MissouriMRDT/Smart_MoCo/README.md

# Smart_MoCo_Hardware

Motor controller breakout with VNH ICs, a microcontroller, and CANbus. 
Transmits encoder, limit switch, and motor controller data over CAN.
