MissouriMRDT/Smart_MoCo/Hardware/board/Smart_MoCo.step

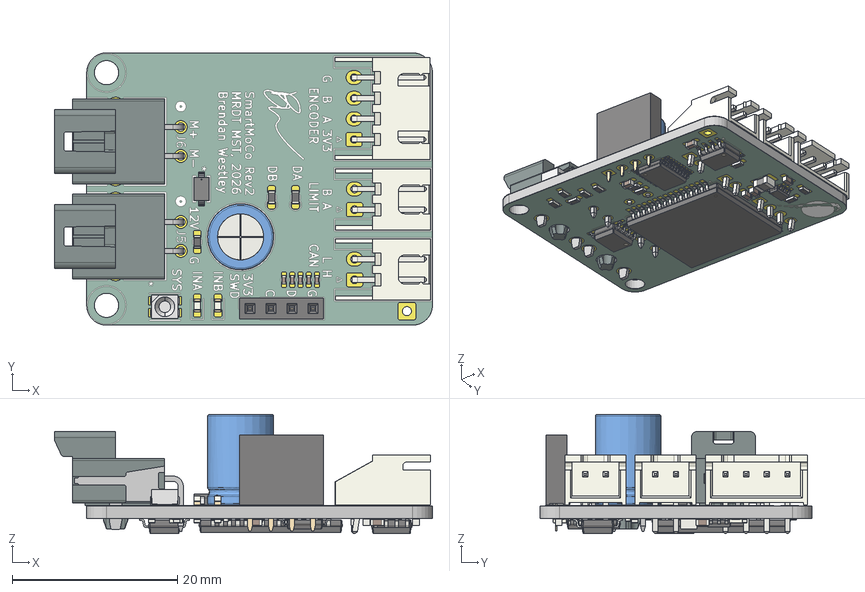
[picture p1: CAD file, 2026-03-16]
Hardware/board/Smart_MoCo.step
45.8 x 33.0 x 14.4 mm
C_0402_1005Metric x 5
R_0603_1608Metric x 13
XZxxxx45
LED_0603_1608Metric x 2
JST_XH_S4B-XH-A_1x04_P2.50mm_Horizontal
C_Radial_D8.0mm_H11.5mm_P3.50mm
JST_XH_S2B-XH-A_1x02_P2.50mm_Horizontal x 2
kicad_embedded_97F6719110B04A8EB39838BF1081E5DA
PinSocket_1x04_P2.54mm_Vertical
SOIC-8_3.9x4.9mm_P1.27mm x 2
TSSOP-20_4.4x6.5mm_P0.65mm
C_0603_1608Metric x 5
L_1008_2520Metric
ST_MultiPowerSO-30
TSOT-23-6
Smart_MoCo_copper
Smart_MoCo_silkscreen x 2
Smart_MoCo_soldermask x 2
Smart_MoCo_PCB
