MissouriMRDT/Smart_MoCo/Hardware/board/simulation/Power Supplies.asc

C1: cap; 1m
I1: current; PWL(0 0 +1m 100m +1m 10m +1m 0 +1u 1u +1u 1u +1u 0 +1m 0 +1n 1 +1n 0)
V1: voltage; 3.3; Rser=10m
Named nets: 0
.tran 0.01
