MissouriMRDT/Smart_MoCo/Hardware/board/Smart_MoCo.kicad_pcb

## KiCad design Hardware/board/Smart_MoCo.kicad_pcb (2026-03-23)

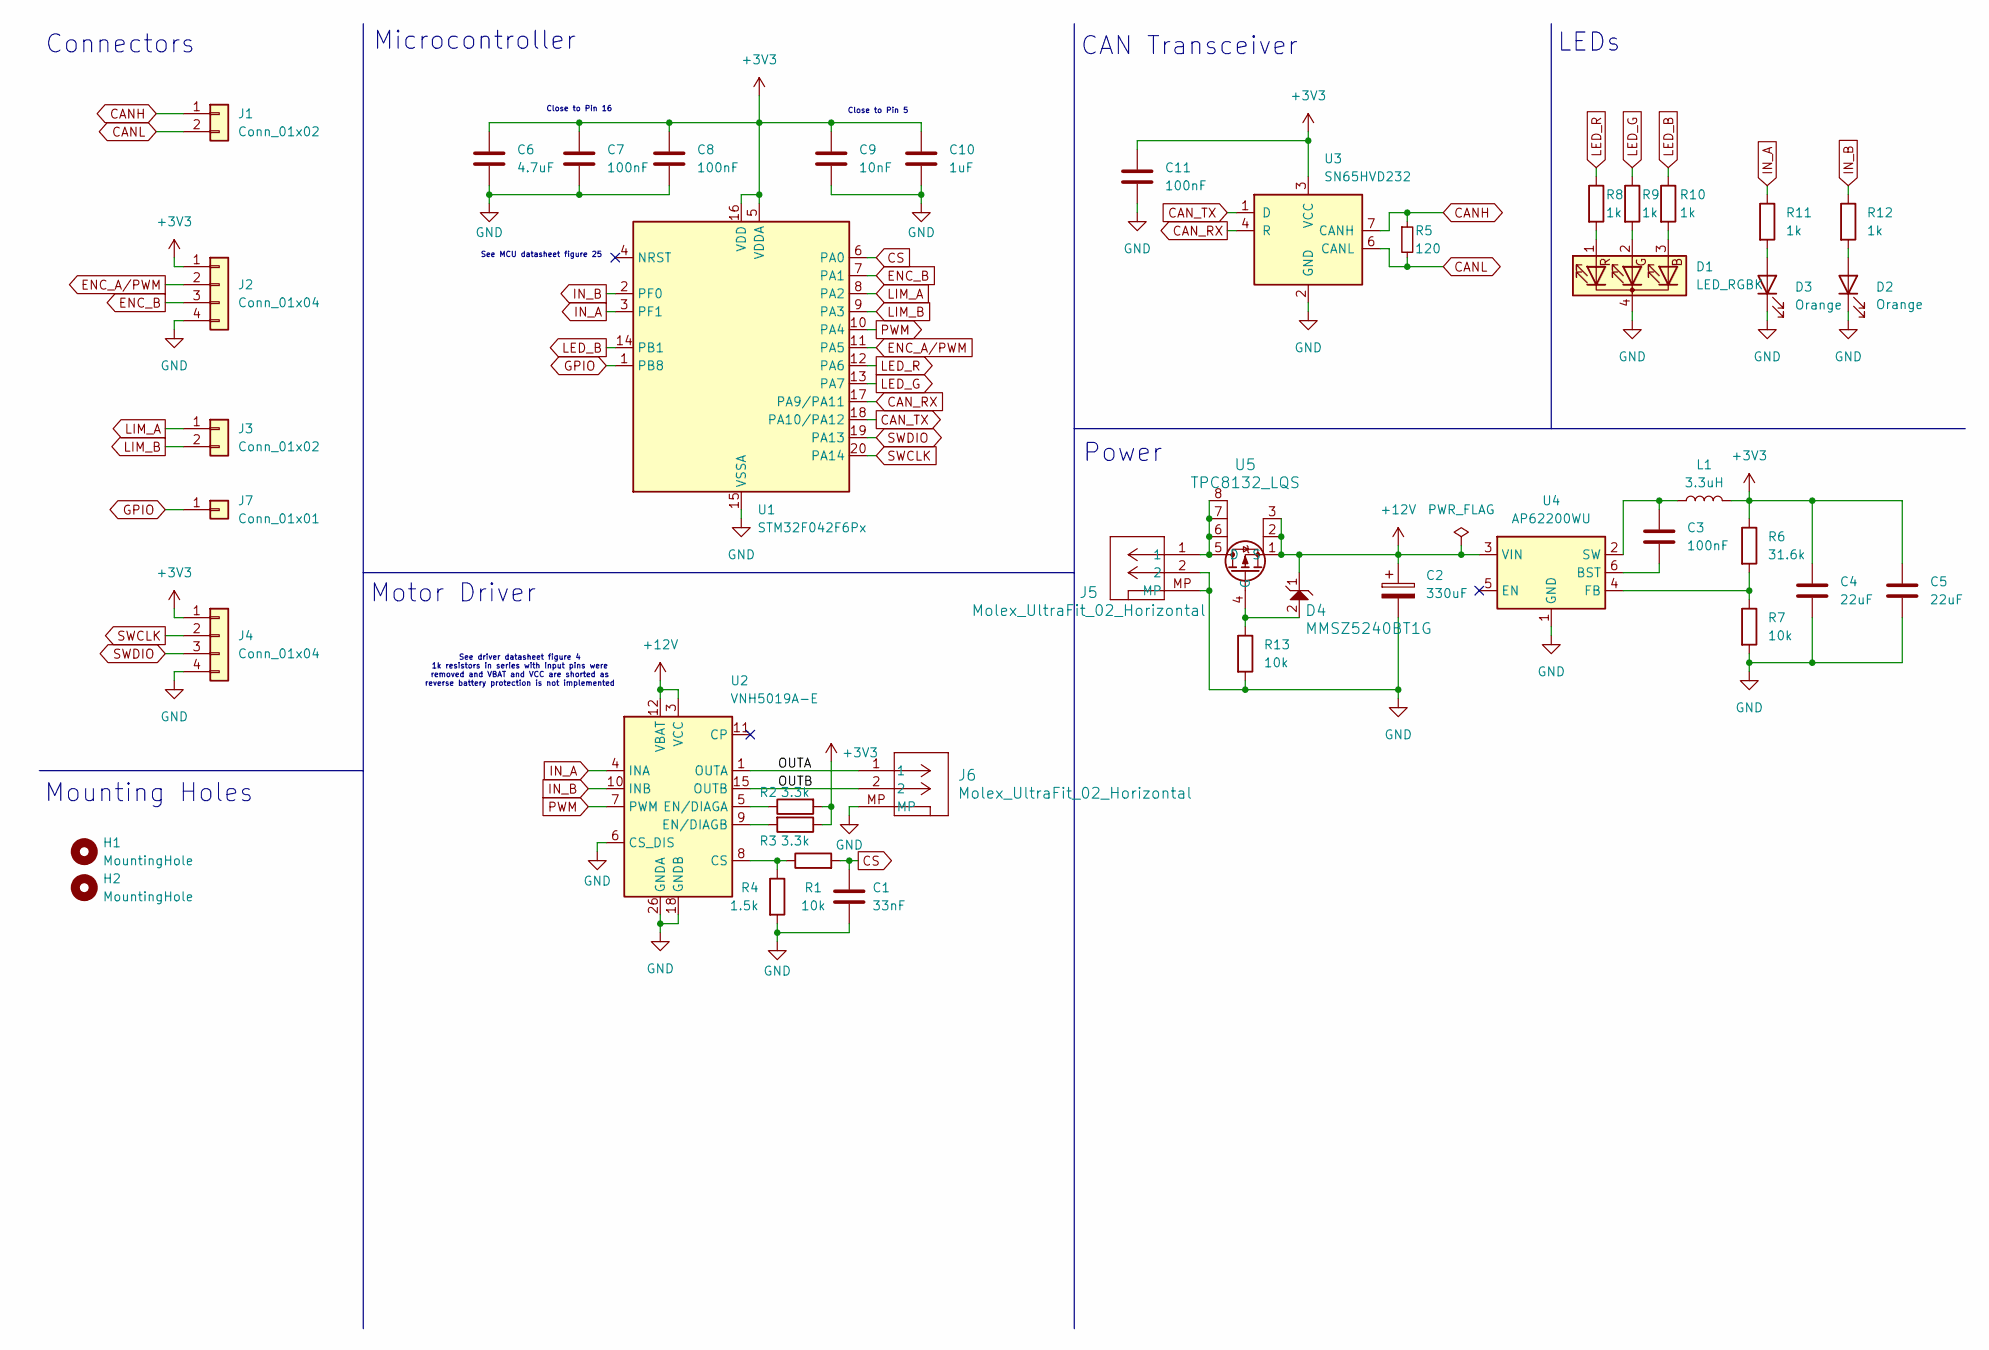
[picture p2: schematic Smart_MoCo.kicad_sch, Smart Brushed Motor Controller]

Parts:
C1: 33nF; C_0603_1608Metric_Pad1.08x0.95mm_HandSolder
C2: 330uF; C_Radial_D8.0mm_H11.5mm_P3.50mm
C3, C11: 100nF; C_0603_1608Metric_Pad1.08x0.95mm_HandSolder
C4, C5: 22uF; C_0603_1608Metric_Pad1.08x0.95mm_HandSolder
C6: 4.7uF; C_0402_1005Metric_Pad0.74x0.62mm_HandSolder
C7, C8: 100nF; C_0402_1005Metric_Pad0.74x0.62mm_HandSolder
C9: 10nF; C_0402_1005Metric_Pad0.74x0.62mm_HandSolder
C10: 1uF; C_0402_1005Metric_Pad0.74x0.62mm_HandSolder
D1: LED_RGBK; PLCC4_3p5x2p8_SLD-L
D2, D3: Orange; LED_0603_1608Metric_Pad1.05x0.95mm_HandSolder
D4: MMSZ5240BT1G; SOD-123_ONS-L
H1, H2: MountingHole; Minimal_4_40_Hole
J1, J3: Conn_01x02; JST_XH_S2B-XH-A_1x02_P2.50mm_Horizontal
J2: Conn_01x04; JST_XH_S4B-XH-A_1x04_P2.50mm_Horizontal
J4: Conn_01x04; PinSocket_1x04_P2.54mm_Vertical
J5, J6: Molex_UltraFit_02_Horizontal; MOLEX_UltraFit_02_Horizontal; MPN 1723102000
J7: Conn_01x01; SolderWire-0.5sqmm_1x01_D0.9mm_OD2.1mm
L1: 3.3uH; L_1008_2520Metric_Pad1.43x2.20mm_HandSolder
R1, R7, R13: 10k; R_0603_1608Metric_Pad0.98x0.95mm_HandSolder
R2, R3: 3.3k; R_0603_1608Metric_Pad0.98x0.95mm_HandSolder
R4: 1.5k; R_0603_1608Metric_Pad0.98x0.95mm_HandSolder
R5: 120; R_0603_1608Metric_Pad0.98x0.95mm_HandSolder
R6: 31.6k; R_0603_1608Metric_Pad0.98x0.95mm_HandSolder
R8, R9, R10, R11, R12: 1k; R_0603_1608Metric_Pad0.98x0.95mm_HandSolder
U1: STM32F042F6Px; TSSOP-20_4.4x6.5mm_P0.65mm
U2: VNH5019A-E; ST_MultiPowerSO-30
U3: SN65HVD232; SOIC-8_3.9x4.9mm_P1.27mm
U4: AP62200WU; TSOT-23-6
U5: TPC8132_LQS; SOIC-8_3.9x4.9mm_P1.27mm

Connections:
+3V3: C4.1, C5.1, C6.1, C7.1, C8.1, C9.1, C10.1, C11.1, J2.1, J4.1, L1.2, R2.2, R3.1, R6.1, U1.5 (VDDA), U1.16 (VDD), U3.3 (VCC)
+12V: C2.1, D4.1, U2.3 (VCC), U2.12 (VBAT), U2.13 (VCC), U2.23 (VCC), U2.31 (VCC), U4.3 (VIN), U5.1 (S), U5.2, U5.3
/OUTA: J6.1, U2.1 (OUTA), U2.25 (OUTA), U2.30 (OUTA), U2.33 (OUTA)
/OUTB: J6.2, U2.15 (OUTB), U2.16 (OUTB), U2.21 (OUTB), U2.32 (OUTB)
CANH: J1.1, R5.1, U3.7 (CANH)
CANL: J1.2, R5.2, U3.6 (CANL)
CAN_RX: U1.17 (PA9/PA11), U3.4 (R)
CAN_TX: U1.18 (PA10/PA12), U3.1 (D)
CS: C1.2, R1.2, U1.6 (PA0)
ENC_A/PWM: J2.2, U1.11 (PA5)
ENC_B: J2.3, U1.7 (PA1)
GND: C1.1, C2.2, C4.2, C5.2, C6.2, C7.2, C8.2, C9.2, C10.2, C11.2, D1.4 (K), D2.1 (K), D3.1 (K), J2.4, J4.4, J5.2, J5.MP, J6.MP, R4.2, R7.2, R13.2, U1.15 (VSSA), U2.6 (CS_DIS), U2.18 (GNDB), U2.19 (GNDB), U2.20 (GNDB), U2.26 (GNDA), U2.27 (GNDA), U2.28 (GNDA), U3.2 (GND), U4.1 (GND)
GPIO: J7.1, U1.1 (PB8)
IN_A: R11.1, U1.3 (PF1), U2.4 (INA)
IN_B: R12.1, U1.2 (PF0), U2.10 (INB)
LED_B: R10.1, U1.14 (PB1)
LED_G: R9.1, U1.13 (PA7)
LED_R: R8.1, U1.12 (PA6)
LIM_A: J3.1, U1.8 (PA2)
LIM_B: J3.2, U1.9 (PA3)
unnamed: D1.3 (BA), R10.2
unnamed: D1.2 (GA), R9.2
unnamed: D1.1 (RA), R8.2
unnamed: D2.2 (A), R12.2
unnamed: D3.2 (A), R11.2
unnamed: R1.1, R4.1, U2.8 (CS)
unnamed: R2.1, U2.5 (EN/DIAGA)
unnamed: R3.2, U2.9 (EN/DIAGB)
unnamed: C3.2, U4.6 (BST)
unnamed: R6.2, R7.1, U4.4 (FB)
unnamed: C3.1, L1.1, U4.2 (SW)
unnamed: J5.1, U5.5 (D), U5.6, U5.7, U5.8
unnamed: D4.2, R13.1, U5.4 (G)
PWM: U1.10 (PA4), U2.7 (PWM)
SWCLK: J4.2, U1.20 (PA14)
SWDIO: J4.3, U1.19 (PA13)

Notes on the sheet:
See MCU datasheet figure 25
Close to Pin 5
See driver datasheet figure 4 1k resistors in series with input pins were removed and VBAT and VCC are shorted as reverse battery protection is not implemented
Close to Pin 16
Power
Connectors
Motor Driver
CAN Transceiver
Microcontroller
LEDs
Mounting Holes

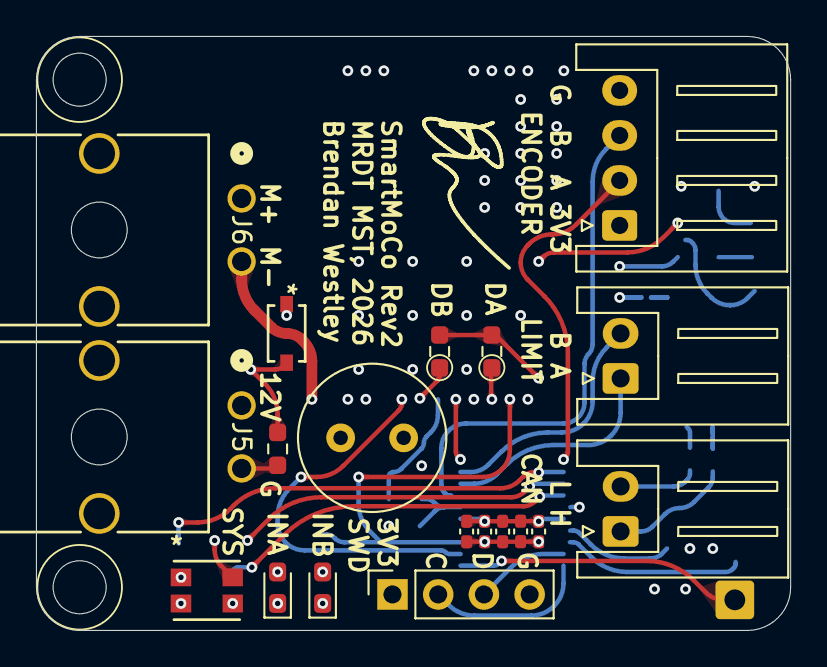
[picture p3: board Smart_MoCo.kicad_pcb from above]

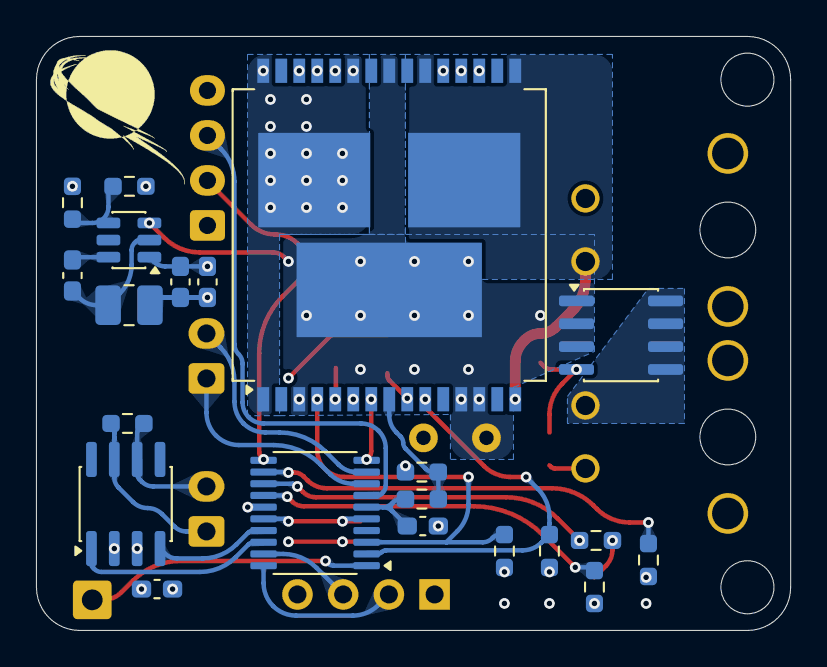
[picture p4: board Smart_MoCo.kicad_pcb from below]

Board: 4 copper layers, 41.9 x 33.0 mm, 43 parts (22 on the bottom side), 36 nets.
