MissouriMRDT/Smart_MoCo/Software/Smart_MoCo/Core/Src/main.c

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
/* Includes ------------------------------------------------------------------*/
#include "main.h"
#include "adc.h"
#include "gpio.h"
#include "tim.h"

/* USER CODE BEGIN Includes */
#include "can.h"
#include "can_rx.h"
#include "encoder.h"
#include <stdbool.h>
#include <stdint.h>

/* USER CODE END Includes */


/* USER CODE BEGIN PV */
volatile uint64_t sysTickOffset = TICKS_PER_MS;
/* USER CODE END PV */

void SystemClock_Config(void);
/**
 * @brief  The application entry point.
 * @retval int
 */
int main(void) {

  /* MCU Configuration--------------------------------------------------------*/

  /* Reset of all peripherals, Initializes the Flash interface and the Systick.
   */
  LL_APB1_GRP2_EnableClock(LL_APB1_GRP2_PERIPH_SYSCFG);
  LL_APB1_GRP1_EnableClock(LL_APB1_GRP1_PERIPH_PWR);

  LL_SYSCFG_EnablePinRemap();

  /* Configure the system clock */
  SystemClock_Config();

  /* Initialize all configured peripherals */
  MX_GPIO_Init();
  MX_ADC_Init();
  MX_TIM2_Init();
  MX_TIM14_Init();
  MX_TIM1_Init();
  MX_TIM17_Init();
  MX_TIM3_Init();
  /* USER CODE BEGIN 2 */
  LL_SYSTICK_EnableIT();
  Controller_Init();
  Encoder_Init();
  CAN_RX_Init();

  LL_TIM_EnableIT_CC1(TIM_SCHEDULER); // Schedule CAN_TX_SendTelemetry
  LL_TIM_EnableIT_CC2(TIM_SCHEDULER); // Schedule CAN_TX_SendDebugTelemetry
  LL_TIM_EnableIT_CC3(TIM_SCHEDULER); // Schedule CAN_TX_RequestMissingParameter
  LL_TIM_EnableIT_CC4(TIM_SCHEDULER); // Schedule CAN_TX_SendDebugTelemetry
  LL_TIM_EnableCounter(TIM_SCHEDULER);
  /* USER CODE END 2 */

  /* Infinite loop */
  /* USER CODE BEGIN WHILE */
  while (1) {
    /* USER CODE END WHILE */

    /* USER CODE BEGIN 3 */
  }
  /* USER CODE END 3 */
}

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
/* USER CODE BEGIN 4 */
uint64_t GetTick(void) { return sysTickOffset - SysTick->VAL; }
/* USER CODE END 4 */
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
