MissouriMRDT/Smart_MoCo/Software/Smart_MoCo/Smart_MoCo.ioc

Mcu.UserName=STM32F042F6Px
PA0.GPIO_Label=CS
PA0.Signal=ADC_IN0
PA1.GPIO_Label=ENC_B
PA1.Signal=S_TIM2_CH2
PA13.Signal=SYS_SWDIO
PA14.Signal=SYS_SWCLK
PA2.GPIO_Label=LIM_A
PA2.Signal=GPIO_Input
PA3.GPIO_Label=LIM_B
PA3.Signal=GPIO_Input
PA4.GPIO_Label=PWM
PA4.Signal=S_TIM14_CH1
PA5.GPIO_Label=ENC_A
PA5.Signal=S_TIM2_CH1_ETR
PA6.GPIO_Label=LED_R
PA6.Signal=S_TIM3_CH1
PA7.GPIO_Label=LED_G
PA7.Signal=S_TIM3_CH2
PB1.GPIO_Label=LED_B
PB1.Signal=S_TIM3_CH4
PB8.GPIO_Label=GPIO
PB8.Signal=GPIO_Input
PF0-OSC_IN.GPIO_Label=IN_B
PF0-OSC_IN.Signal=GPIO_Output
PF1-OSC_OUT.GPIO_Label=IN_A
PF1-OSC_OUT.Signal=GPIO_Output
