MissouriMRDT/Smart_MoCo/Software/Smart_MoCo/Core/Inc/main.h

#define GPIO_Pin LL_GPIO_PIN_8
#define GPIO_GPIO_Port GPIOB
#define IN_B_Pin LL_GPIO_PIN_0
#define IN_B_GPIO_Port GPIOF
#define IN_A_Pin LL_GPIO_PIN_1
#define IN_A_GPIO_Port GPIOF
#define CS_Pin LL_GPIO_PIN_0
#define CS_GPIO_Port GPIOA
#define ENC_B_Pin LL_GPIO_PIN_1
#define ENC_B_GPIO_Port GPIOA
#define LIM_A_Pin LL_GPIO_PIN_2
#define LIM_A_GPIO_Port GPIOA
#define LIM_B_Pin LL_GPIO_PIN_3
#define LIM_B_GPIO_Port GPIOA
#define PWM_Pin LL_GPIO_PIN_4
#define PWM_GPIO_Port GPIOA
#define ENC_A_Pin LL_GPIO_PIN_5
#define ENC_A_GPIO_Port GPIOA
#define LED_R_Pin LL_GPIO_PIN_6
#define LED_R_GPIO_Port GPIOA
#define LED_G_Pin LL_GPIO_PIN_7
#define LED_G_GPIO_Port GPIOA
#define LED_B_Pin LL_GPIO_PIN_1
#define LED_B_GPIO_Port GPIOB
#define NVIC_PRIORITYGROUP_0                                                   \
#define NVIC_PRIORITYGROUP_1                                                   \
#define NVIC_PRIORITYGROUP_2                                                   \
#define NVIC_PRIORITYGROUP_3                                                   \
#define NVIC_PRIORITYGROUP_4                                                   \
#define TICKS_PER_S 8000000
#define TICKS_PER_MS 8000
#define TICKS_PER_US 8
#define TIM_SCHEDULER TIM1
#define TIM_ENCODER TIM2
#define TIM_LED TIM3
#define TIM_MOTOR TIM14
#define TIM_GPIO TIM16
#define TIM_OUTPUT TIM17
