MissouriMRDT/Smart_MoCo/Software/Smart_MoCo/Core/Inc/controller.h

#ifndef __CONTROLLER_H
#define __CONTROLLER_H

#include "smoco.h"
#include <stdint.h>

typedef enum ControlMode {
  CONTROL_MODE_STOP,
  CONTROL_MODE_OPEN_LOOP,
  CONTROL_MODE_POSITION,
  CONTROL_MODE_VELOCITY,
  CONTROL_MODE_CURRENT,
  CONTROL_MODE_CALIBRATING,
  CONTROL_MODE_COUNT, // Sentinel
} ControlMode;

typedef struct Color {
  uint16_t r;
  uint16_t g;
  uint16_t b;
} Color;

extern DebugTelemetry debugTelemetry;

void TIM17_PeriodElapsedCallback(void);
void Controller_Init(void);
void Controller_SetStatusLED(uint64_t timeout, uint8_t priority, Color color);
void Controller_ResetPID(void);

#endif /* __CONTROLLER_H */
