MissouriMRDT/Smart_MoCo/Software/Smart_MoCo/Core/Src/tim.c

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
/* Includes ------------------------------------------------------------------*/
#include "tim.h"

/* TIM1 init function */
void MX_TIM1_Init(void) {

  LL_TIM_InitTypeDef TIM_InitStruct = {0};
  LL_TIM_OC_InitTypeDef TIM_OC_InitStruct = {0};
  LL_TIM_BDTR_InitTypeDef TIM_BDTRInitStruct = {0};

  /* Peripheral clock enable */
  LL_APB1_GRP2_EnableClock(LL_APB1_GRP2_PERIPH_TIM1);

  /* TIM1 interrupt Init */
  NVIC_SetPriority(TIM1_CC_IRQn, 2);
  NVIC_EnableIRQ(TIM1_CC_IRQn);

  TIM_InitStruct.Prescaler = 4000 - LL_TIM_IC_FILTER_FDIV1_N2;
  TIM_InitStruct.CounterMode = LL_TIM_COUNTERMODE_UP;
  TIM_InitStruct.Autoreload = 200 - LL_TIM_IC_FILTER_FDIV1_N2;
  TIM_InitStruct.ClockDivision = LL_TIM_CLOCKDIVISION_DIV2;
  TIM_InitStruct.RepetitionCounter = 0;
  LL_TIM_Init(TIM1, &TIM_InitStruct);
  LL_TIM_DisableARRPreload(TIM1);
  LL_TIM_SetClockSource(TIM1, LL_TIM_CLOCKSOURCE_INTERNAL);
  TIM_OC_InitStruct.OCMode = LL_TIM_OCMODE_FROZEN;
  TIM_OC_InitStruct.OCState = LL_TIM_OCSTATE_DISABLE;
  TIM_OC_InitStruct.OCNState = LL_TIM_OCSTATE_DISABLE;
  TIM_OC_InitStruct.CompareValue = 0;
  TIM_OC_InitStruct.OCPolarity = LL_TIM_OCPOLARITY_HIGH;
  TIM_OC_InitStruct.OCNPolarity = LL_TIM_OCPOLARITY_HIGH;
  TIM_OC_InitStruct.OCIdleState = LL_TIM_OCIDLESTATE_LOW;
  TIM_OC_InitStruct.OCNIdleState = LL_TIM_OCIDLESTATE_LOW;
  LL_TIM_OC_Init(TIM1, LL_TIM_CHANNEL_CH1, &TIM_OC_InitStruct);
  LL_TIM_OC_DisableFast(TIM1, LL_TIM_CHANNEL_CH1);
  TIM_OC_InitStruct.CompareValue = 50;
  LL_TIM_OC_Init(TIM1, LL_TIM_CHANNEL_CH2, &TIM_OC_InitStruct);
  LL_TIM_OC_DisableFast(TIM1, LL_TIM_CHANNEL_CH2);
  TIM_OC_InitStruct.CompareValue = 100;
  LL_TIM_OC_Init(TIM1, LL_TIM_CHANNEL_CH3, &TIM_OC_InitStruct);
  LL_TIM_OC_DisableFast(TIM1, LL_TIM_CHANNEL_CH3);
  TIM_OC_InitStruct.CompareValue = 150;
  LL_TIM_OC_Init(TIM1, LL_TIM_CHANNEL_CH4, &TIM_OC_InitStruct);
  LL_TIM_OC_DisableFast(TIM1, LL_TIM_CHANNEL_CH4);
  LL_TIM_SetTriggerOutput(TIM1, LL_TIM_TRGO_RESET);
  LL_TIM_DisableMasterSlaveMode(TIM1);
  TIM_BDTRInitStruct.OSSRState = LL_TIM_OSSR_DISABLE;
  TIM_BDTRInitStruct.OSSIState = LL_TIM_OSSI_DISABLE;
  TIM_BDTRInitStruct.LockLevel = LL_TIM_LOCKLEVEL_OFF;
  TIM_BDTRInitStruct.DeadTime = 0;
  TIM_BDTRInitStruct.BreakState = LL_TIM_BREAK_DISABLE;
  TIM_BDTRInitStruct.BreakPolarity = LL_TIM_BREAK_POLARITY_HIGH;
  TIM_BDTRInitStruct.AutomaticOutput = LL_TIM_AUTOMATICOUTPUT_DISABLE;
  LL_TIM_BDTR_Init(TIM1, &TIM_BDTRInitStruct);
}
/* TIM2 init function */
void MX_TIM2_Init(void) {

  /* USER CODE BEGIN TIM2_Init 0 */
#ifdef QUADRATURE_ENCODER
  /* USER CODE END TIM2_Init 0 */

  LL_TIM_InitTypeDef TIM_InitStruct = {0};

  LL_GPIO_InitTypeDef GPIO_InitStruct = {0};

  /* Peripheral clock enable */
  LL_APB1_GRP1_EnableClock(LL_APB1_GRP1_PERIPH_TIM2);

  LL_AHB1_GRP1_EnableClock(LL_AHB1_GRP1_PERIPH_GPIOA);
  /**TIM2 GPIO Configuration
  PA1   ------> TIM2_CH2
  PA5   ------> TIM2_CH1
  */
  GPIO_InitStruct.Pin = ENC_B_Pin;
  GPIO_InitStruct.Mode = LL_GPIO_MODE_ALTERNATE;
  GPIO_InitStruct.Speed = LL_GPIO_SPEED_FREQ_LOW;
  GPIO_InitStruct.OutputType = LL_GPIO_OUTPUT_PUSHPULL;
  GPIO_InitStruct.Pull = LL_GPIO_PULL_NO;
  GPIO_InitStruct.Alternate = LL_GPIO_AF_2;
  LL_GPIO_Init(ENC_B_GPIO_Port, &GPIO_InitStruct);

  GPIO_InitStruct.Pin = ENC_A_Pin;
  GPIO_InitStruct.Mode = LL_GPIO_MODE_ALTERNATE;
  GPIO_InitStruct.Speed = LL_GPIO_SPEED_FREQ_LOW;
  GPIO_InitStruct.OutputType = LL_GPIO_OUTPUT_PUSHPULL;
  GPIO_InitStruct.Pull = LL_GPIO_PULL_NO;
  GPIO_InitStruct.Alternate = LL_GPIO_AF_2;
  LL_GPIO_Init(ENC_A_GPIO_Port, &GPIO_InitStruct);

  LL_TIM_SetEncoderMode(TIM2, LL_TIM_ENCODERMODE_X4_TI12);
  LL_TIM_IC_SetActiveInput(TIM2, LL_TIM_CHANNEL_CH1,
                           LL_TIM_ACTIVEINPUT_DIRECTTI);
  LL_TIM_IC_SetPrescaler(TIM2, LL_TIM_CHANNEL_CH1, LL_TIM_ICPSC_DIV1);
  LL_TIM_IC_SetFilter(TIM2, LL_TIM_CHANNEL_CH1, LL_TIM_IC_FILTER_FDIV1);
  LL_TIM_IC_SetPolarity(TIM2, LL_TIM_CHANNEL_CH1, LL_TIM_IC_POLARITY_RISING);
  LL_TIM_IC_SetActiveInput(TIM2, LL_TIM_CHANNEL_CH2,
                           LL_TIM_ACTIVEINPUT_DIRECTTI);
  LL_TIM_IC_SetPrescaler(TIM2, LL_TIM_CHANNEL_CH2, LL_TIM_ICPSC_DIV1);
  LL_TIM_IC_SetFilter(TIM2, LL_TIM_CHANNEL_CH2, LL_TIM_IC_FILTER_FDIV1);
  LL_TIM_IC_SetPolarity(TIM2, LL_TIM_CHANNEL_CH2, LL_TIM_IC_POLARITY_RISING);
  TIM_InitStruct.Prescaler = 0;
  TIM_InitStruct.CounterMode = LL_TIM_COUNTERMODE_UP;
  TIM_InitStruct.Autoreload = 4294967295;
  TIM_InitStruct.ClockDivision = LL_TIM_CLOCKDIVISION_DIV1;
  LL_TIM_Init(TIM2, &TIM_InitStruct);
  LL_TIM_DisableARRPreload(TIM2);
  LL_TIM_SetTriggerOutput(TIM2, LL_TIM_TRGO_RESET);
  LL_TIM_DisableMasterSlaveMode(TIM2);
  /* USER CODE BEGIN TIM2_Init 2 */
#else
  LL_TIM_InitTypeDef TIM_InitStruct = {0};

  LL_GPIO_InitTypeDef GPIO_InitStruct = {0};

  /* Peripheral clock enable */
  LL_APB1_GRP1_EnableClock(LL_APB1_GRP1_PERIPH_TIM2);

  LL_AHB1_GRP1_EnableClock(LL_AHB1_GRP1_PERIPH_GPIOA);
  /**TIM2 GPIO Configuration
  PA5   ------> TIM2_CH1
  */
  GPIO_InitStruct.Pin = ENC_A_Pin;
  GPIO_InitStruct.Mode = LL_GPIO_MODE_ALTERNATE;
  GPIO_InitStruct.Speed = LL_GPIO_SPEED_FREQ_LOW;
  GPIO_InitStruct.OutputType = LL_GPIO_OUTPUT_PUSHPULL;
  GPIO_InitStruct.Pull = LL_GPIO_PULL_NO;
  GPIO_InitStruct.Alternate = LL_GPIO_AF_2;
  LL_GPIO_Init(ENC_A_GPIO_Port, &GPIO_InitStruct);

  /* TIM2 interrupt Init */
  NVIC_SetPriority(TIM2_IRQn, 0);
  NVIC_EnableIRQ(TIM2_IRQn);

  TIM_InitStruct.Prescaler = 0;
  TIM_InitStruct.CounterMode = LL_TIM_COUNTERMODE_UP;
  TIM_InitStruct.Autoreload = 4294967295;
  TIM_InitStruct.ClockDivision = LL_TIM_CLOCKDIVISION_DIV1;
  LL_TIM_Init(TIM2, &TIM_InitStruct);
  LL_TIM_DisableARRPreload(TIM2);
  LL_TIM_SetTriggerInput(TIM2, LL_TIM_TS_TI1FP1);
  LL_TIM_SetSlaveMode(TIM2, LL_TIM_SLAVEMODE_RESET);
  LL_TIM_CC_DisableChannel(TIM2, LL_TIM_CHANNEL_CH1);
  LL_TIM_IC_SetFilter(TIM2, LL_TIM_CHANNEL_CH1, LL_TIM_IC_FILTER_FDIV1);
  LL_TIM_IC_SetPolarity(TIM2, LL_TIM_CHANNEL_CH1, LL_TIM_IC_POLARITY_RISING);
  LL_TIM_DisableIT_TRIG(TIM2);
  LL_TIM_DisableDMAReq_TRIG(TIM2);
  LL_TIM_IC_SetActiveInput(TIM2, LL_TIM_CHANNEL_CH1,
                           LL_TIM_ACTIVEINPUT_DIRECTTI);
  LL_TIM_IC_SetPrescaler(TIM2, LL_TIM_CHANNEL_CH1, LL_TIM_ICPSC_DIV1);
  LL_TIM_IC_SetActiveInput(TIM2, LL_TIM_CHANNEL_CH2,
                           LL_TIM_ACTIVEINPUT_INDIRECTTI);
  LL_TIM_IC_SetPrescaler(TIM2, LL_TIM_CHANNEL_CH2, LL_TIM_ICPSC_DIV1);
  LL_TIM_IC_SetFilter(TIM2, LL_TIM_CHANNEL_CH2, LL_TIM_IC_FILTER_FDIV1);
  LL_TIM_IC_SetPolarity(TIM2, LL_TIM_CHANNEL_CH2, LL_TIM_IC_POLARITY_FALLING);
  LL_TIM_SetTriggerOutput(TIM2, LL_TIM_TRGO_RESET);
  LL_TIM_DisableMasterSlaveMode(TIM2);
#endif
  /* USER CODE END TIM2_Init 2 */
}
/* TIM3 init function */
void MX_TIM3_Init(void) {

  LL_TIM_InitTypeDef TIM_InitStruct = {0};
  LL_TIM_OC_InitTypeDef TIM_OC_InitStruct = {0};

  LL_GPIO_InitTypeDef GPIO_InitStruct = {0};
  /* Peripheral clock enable */
  LL_APB1_GRP1_EnableClock(LL_APB1_GRP1_PERIPH_TIM3);

  TIM_InitStruct.Prescaler = 0;
  TIM_InitStruct.CounterMode = LL_TIM_COUNTERMODE_UP;
  TIM_InitStruct.Autoreload = 65535;
  TIM_InitStruct.ClockDivision = LL_TIM_CLOCKDIVISION_DIV1;
  LL_TIM_Init(TIM3, &TIM_InitStruct);
  LL_TIM_DisableARRPreload(TIM3);
  LL_TIM_SetClockSource(TIM3, LL_TIM_CLOCKSOURCE_INTERNAL);
  LL_TIM_OC_EnablePreload(TIM3, LL_TIM_CHANNEL_CH1);
  TIM_OC_InitStruct.OCMode = LL_TIM_OCMODE_PWM1;
  TIM_OC_InitStruct.OCState = LL_TIM_OCSTATE_DISABLE;
  TIM_OC_InitStruct.OCNState = LL_TIM_OCSTATE_DISABLE;
  TIM_OC_InitStruct.CompareValue = 0;
  TIM_OC_InitStruct.OCPolarity = LL_TIM_OCPOLARITY_HIGH;
  LL_TIM_OC_Init(TIM3, LL_TIM_CHANNEL_CH1, &TIM_OC_InitStruct);
  LL_TIM_OC_DisableFast(TIM3, LL_TIM_CHANNEL_CH1);
  LL_TIM_OC_EnablePreload(TIM3, LL_TIM_CHANNEL_CH2);
  LL_TIM_OC_Init(TIM3, LL_TIM_CHANNEL_CH2, &TIM_OC_InitStruct);
  LL_TIM_OC_DisableFast(TIM3, LL_TIM_CHANNEL_CH2);
  LL_TIM_OC_EnablePreload(TIM3, LL_TIM_CHANNEL_CH4);
  LL_TIM_OC_Init(TIM3, LL_TIM_CHANNEL_CH4, &TIM_OC_InitStruct);
  LL_TIM_OC_DisableFast(TIM3, LL_TIM_CHANNEL_CH4);
  LL_TIM_SetTriggerOutput(TIM3, LL_TIM_TRGO_RESET);
  LL_TIM_DisableMasterSlaveMode(TIM3);
  LL_AHB1_GRP1_EnableClock(LL_AHB1_GRP1_PERIPH_GPIOA);
  LL_AHB1_GRP1_EnableClock(LL_AHB1_GRP1_PERIPH_GPIOB);
  /**TIM3 GPIO Configuration
  PA6     ------> TIM3_CH1
  PA7     ------> TIM3_CH2
  PB1     ------> TIM3_CH4
  */
  GPIO_InitStruct.Pin = LED_R_Pin;
  GPIO_InitStruct.Mode = LL_GPIO_MODE_ALTERNATE;
  GPIO_InitStruct.Speed = LL_GPIO_SPEED_FREQ_LOW;
  GPIO_InitStruct.OutputType = LL_GPIO_OUTPUT_PUSHPULL;
  GPIO_InitStruct.Pull = LL_GPIO_PULL_NO;
  GPIO_InitStruct.Alternate = LL_GPIO_AF_1;
  LL_GPIO_Init(LED_R_GPIO_Port, &GPIO_InitStruct);

  GPIO_InitStruct.Pin = LED_G_Pin;
  GPIO_InitStruct.Mode = LL_GPIO_MODE_ALTERNATE;
  GPIO_InitStruct.Speed = LL_GPIO_SPEED_FREQ_LOW;
  GPIO_InitStruct.OutputType = LL_GPIO_OUTPUT_PUSHPULL;
  GPIO_InitStruct.Pull = LL_GPIO_PULL_NO;
  GPIO_InitStruct.Alternate = LL_GPIO_AF_1;
  LL_GPIO_Init(LED_G_GPIO_Port, &GPIO_InitStruct);

  GPIO_InitStruct.Pin = LED_B_Pin;
  GPIO_InitStruct.Mode = LL_GPIO_MODE_ALTERNATE;
  GPIO_InitStruct.Speed = LL_GPIO_SPEED_FREQ_LOW;
  GPIO_InitStruct.OutputType = LL_GPIO_OUTPUT_PUSHPULL;
  GPIO_InitStruct.Pull = LL_GPIO_PULL_NO;
  GPIO_InitStruct.Alternate = LL_GPIO_AF_1;
  LL_GPIO_Init(LED_B_GPIO_Port, &GPIO_InitStruct);
}
/* TIM14 init function */
void MX_TIM14_Init(void) {

  LL_TIM_InitTypeDef TIM_InitStruct = {0};
  LL_TIM_OC_InitTypeDef TIM_OC_InitStruct = {0};

  LL_GPIO_InitTypeDef GPIO_InitStruct = {0};
  /* Peripheral clock enable */
  LL_APB1_GRP1_EnableClock(LL_APB1_GRP1_PERIPH_TIM14);

  TIM_InitStruct.Prescaler = 0;
  TIM_InitStruct.CounterMode = LL_TIM_COUNTERMODE_UP;
  TIM_InitStruct.Autoreload = 65535;
  TIM_InitStruct.ClockDivision = LL_TIM_CLOCKDIVISION_DIV1;
  LL_TIM_Init(TIM14, &TIM_InitStruct);
  LL_TIM_DisableARRPreload(TIM14);
  LL_TIM_OC_EnablePreload(TIM14, LL_TIM_CHANNEL_CH1);
  TIM_OC_InitStruct.OCMode = LL_TIM_OCMODE_PWM1;
  TIM_OC_InitStruct.OCState = LL_TIM_OCSTATE_DISABLE;
  TIM_OC_InitStruct.OCNState = LL_TIM_OCSTATE_DISABLE;
  TIM_OC_InitStruct.CompareValue = 0;
  TIM_OC_InitStruct.OCPolarity = LL_TIM_OCPOLARITY_HIGH;
  LL_TIM_OC_Init(TIM14, LL_TIM_CHANNEL_CH1, &TIM_OC_InitStruct);
  LL_TIM_OC_DisableFast(TIM14, LL_TIM_CHANNEL_CH1);
  LL_AHB1_GRP1_EnableClock(LL_AHB1_GRP1_PERIPH_GPIOA);
  /**TIM14 GPIO Configuration
  PA4     ------> TIM14_CH1
  */
  GPIO_InitStruct.Pin = PWM_Pin;
  GPIO_InitStruct.Mode = LL_GPIO_MODE_ALTERNATE;
  GPIO_InitStruct.Speed = LL_GPIO_SPEED_FREQ_LOW;
  GPIO_InitStruct.OutputType = LL_GPIO_OUTPUT_PUSHPULL;
  GPIO_InitStruct.Pull = LL_GPIO_PULL_NO;
  GPIO_InitStruct.Alternate = LL_GPIO_AF_4;
  LL_GPIO_Init(PWM_GPIO_Port, &GPIO_InitStruct);
}
/* TIM17 init function */
void MX_TIM17_Init(void) {

  LL_TIM_InitTypeDef TIM_InitStruct = {0};

  /* Peripheral clock enable */
  LL_APB1_GRP2_EnableClock(LL_APB1_GRP2_PERIPH_TIM17);

  /* TIM17 interrupt Init */
  NVIC_SetPriority(TIM17_IRQn, 1);
  NVIC_EnableIRQ(TIM17_IRQn);

  TIM_InitStruct.Prescaler =
      LL_TIM_IC_FILTER_FDIV2_N6 - LL_TIM_IC_FILTER_FDIV1_N2;
  TIM_InitStruct.CounterMode = LL_TIM_COUNTERMODE_UP;
  TIM_InitStruct.Autoreload = 40000 - LL_TIM_IC_FILTER_FDIV1_N2;
  TIM_InitStruct.ClockDivision = LL_TIM_CLOCKDIVISION_DIV1;
  TIM_InitStruct.RepetitionCounter = 0;
  LL_TIM_Init(TIM17, &TIM_InitStruct);
  LL_TIM_DisableARRPreload(TIM17);
}
