MissouriMRDT/Smart_MoCo/(commit log)

2024-09-23 Added KiCAD files
    [Smart_MoCo_Hardware.kicad_pcb, Smart_MoCo_Hardware.kicad_sch]
2024-09-23 Create KiCAD projects for breakout boards
    [Buck_Breakout.kicad_pcb, Buck_Breakout.kicad_sch, STM_Breakout.kicad_pcb, STM_Breakout.kicad_sch, Smart_MoCo.kicad_pcb, Smart_MoCo.kicad_sch]
2024-09-26 Create breakout for STM32 and CAN transceiver
    [STM_Breakout.kicad_sch]
2024-09-26 Made buck circuit
    [Buck_Converter1.kicad_pcb, Buck_Converter1.kicad_sch]
2024-09-26 Made buck converter in buck breakout
    [Buck_Breakout.kicad_sch, Buck_Converter1.kicad_pcb, Buck_Converter1.kicad_sch]
2024-10-05 Finish STM Breakout Schematic
    [STM_Breakout.kicad_sch]
2024-10-05 Footprint assignments for STM Breakout
    [STM_Breakout.kicad_sch]
2024-10-13 Finish Buck converter schematic and footprint assignments
    [Buck_Breakout.kicad_sch]
2024-10-13 Finish buck converter layout
    [Buck_Breakout.kicad_pcb, Buck_Breakout.kicad_sch]
2024-10-13 Generate BOM for buck breakout
    [Buck_Breakout.kicad_pcb, Buck_Breakout.kicad_sch]
2024-10-14 Finish STM32 Breakout Layout
    [STM_Breakout.kicad_pcb]
2024-10-14 Generate BOM for STM32 breakout
2024-10-14 Increase header pitch in STM32 breakout
    [STM_Breakout.kicad_pcb, STM_Breakout.kicad_sch]
2024-10-16 Add second capacitor to buck breakout output
    [Buck_Breakout.kicad_pcb, Buck_Breakout.kicad_sch]
2024-10-22 Replace reset button with jumper
    [STM_Breakout.kicad_pcb, STM_Breakout.kicad_sch]
2024-11-01 Generated gerbs for buck and STM32 breakouts
    [Buck_Breakout-B_Cu.gbr, Buck_Breakout-B_Mask.gbr, Buck_Breakout-B_Paste.gbr, Buck_Breakout-B_Silkscreen.gbr, Buck_Breakout-Edge_Cuts.gbr, Buck_Breakout-F_Cu.gbr, Buck_Breakout-F_Mask.gbr, Buck_Breakout-F_Paste.gbr]
2024-11-01 Added drill files
    [Buck_Breakout-NPTH.drl, Buck_Breakout-PTH.drl, STM_Breakout-NPTH.drl, STM_Breakout-PTH.drl]
2025-03-31 Initial design
    [Smart_MoCo.kicad_pcb, Smart_MoCo.kicad_sch]
2025-04-01 Modify CAN circuit
    [Smart_MoCo.kicad_pcb, Smart_MoCo.kicad_sch]
2025-04-01 Add Buck_Converter daughterboard
    [Buck_Converter.kicad_pcb, Buck_Converter.kicad_sch]
2025-04-03 Implement schematic first review feedback and finish PCB layout
    [Smart_MoCo.kicad_pcb, Smart_MoCo.kicad_sch]
2025-04-03 Add Buck Converter pin labels
    [Buck_Converter.kicad_pcb]
2025-04-08 Prepare for board review
    [Buck_Converter.kicad_pcb, Buck_Converter.kicad_sch, Smart_MoCo.kicad_pcb, Smart_MoCo.kicad_sch]
2025-04-08 Update LED resistor values
    [Smart_MoCo.kicad_pcb, Smart_MoCo.kicad_sch]
2025-04-09 Implement board review changes
    [Buck_Converter-B_Cu.gbr, Buck_Converter-B_Mask.gbr, Buck_Converter-B_Paste.gbr, Buck_Converter-B_Silkscreen.gbr, Buck_Converter-Edge_Cuts.gbr, Buck_Converter-F_Cu.gbr, Buck_Converter-F_Mask.gbr, Buck_Converter-F_Paste.gbr]
2025-08-27 CAN Testing
    [Smart_MoCo.kicad_pcb]
2025-10-24 Tested error messages, open loop control
    [Smart_MoCo.ioc, main.c, main.h]
2025-11-01 Change power connectors, increase layer count to 4, and reroute
    [Smart_MoCo.kicad_pcb, Smart_MoCo.kicad_sch]
2025-11-02 Change power connectors again
    [Smart_MoCo.kicad_pcb, Smart_MoCo.kicad_sch]
2025-11-02 Melt traces
    [Smart_MoCo.kicad_pcb]
2025-11-02 Move mounting hole
    [Smart_MoCo.kicad_pcb]
2025-11-05 Change signal connectors to horizontal JST SH
    [Smart_MoCo.kicad_pcb, Smart_MoCo.kicad_sch]
2025-11-05 Shrink board to 27x40mm
    [Smart_MoCo.kicad_pcb, Smart_MoCo.kicad_sch]
2025-11-10 Update gerbs and bom
    [Smart_MoCo-B_Cu.gbr, Smart_MoCo-B_Mask.gbr, Smart_MoCo-B_Paste.gbr, Smart_MoCo-B_Silkscreen.gbr, Smart_MoCo-Edge_Cuts.gbr, Smart_MoCo-F_Cu.gbr, Smart_MoCo-F_Mask.gbr, Smart_MoCo-F_Paste.gbr]
2025-11-10 Update bom
2025-11-11 Add step
    [Smart_MoCo.kicad_pcb, Smart_MoCo.step]
2025-11-11 Added bulk capacitors and kicad github action
    [Smart_MoCo.kicad_pcb, Smart_MoCo.kicad_sch]
2025-11-12 Via stitch 12V and OUT planes
    [Smart_MoCo.kicad_pcb]
2025-11-12 Update via stitching
    [Smart_MoCo.kicad_pcb]
2025-11-12 Fix vias on edges of pads
    [Smart_MoCo.kicad_pcb]
2025-11-12 Rebuild fills and update step
    [Smart_MoCo.kicad_pcb, Smart_MoCo.step]
2025-12-10 Added absolute and quadurature encoder support
2025-12-10 Reorganize Hardware folder and remove unused boards
    [Buck_Breakout-B_Cu.gbr, Buck_Breakout-B_Mask.gbr, Buck_Breakout-B_Paste.gbr, Buck_Breakout-B_Silkscreen.gbr, Buck_Breakout-Edge_Cuts.gbr, Buck_Breakout-F_Cu.gbr, Buck_Breakout-F_Mask.gbr, Buck_Breakout-F_Paste.gbr]
2025-12-16 Correct silkscreen labels
    [Smart_MoCo.kicad_pcb]
2025-12-23 Correct tick timer
2026-02-04 Add filtering to ignore ext ids
2026-03-15 Redesign hardware
    [Smart_MoCo-B_Cu.gbr, Smart_MoCo-B_Mask.gbr, Smart_MoCo-B_Paste.gbr, Smart_MoCo-B_Silkscreen.gbr, Smart_MoCo-Edge_Cuts.gbr, Smart_MoCo-F_Cu.gbr, Smart_MoCo-F_Mask.gbr, Smart_MoCo-F_Paste.gbr]
2026-03-15 Incorporate review 1 feedback
    [Smart_MoCo-B_Cu.gbr, Smart_MoCo-B_Mask.gbr, Smart_MoCo-B_Paste.gbr, Smart_MoCo-B_Silkscreen.gbr, Smart_MoCo-Edge_Cuts.gbr, Smart_MoCo-F_Cu.gbr, Smart_MoCo-F_Mask.gbr, Smart_MoCo-F_Paste.gbr]
2026-03-16 Incorporate review 2 feedback
    [Smart_MoCo-B_Cu.gbr, Smart_MoCo-B_Mask.gbr, Smart_MoCo-B_Paste.gbr, Smart_MoCo-B_Silkscreen.gbr, Smart_MoCo-Edge_Cuts.gbr, Smart_MoCo-F_Cu.gbr, Smart_MoCo-F_Mask.gbr, Smart_MoCo-F_Paste.gbr]
2026-03-23 Final design files as ordered
    [Smart_MoCo-B_Cu.gbr, Smart_MoCo-B_Mask.gbr, Smart_MoCo-B_Paste.gbr, Smart_MoCo-B_Silkscreen.gbr, Smart_MoCo-Edge_Cuts.gbr, Smart_MoCo-F_Cu.gbr, Smart_MoCo-F_Mask.gbr, Smart_MoCo-F_Paste.gbr]
2026-03-23 Change CAN packet description and switch from HAL to LL
2026-04-10 Implement working scheduler, CAN, limit switch, encoder, open loop
2026-04-10 Migrate to Rev2 hardware, add RGB, fix calibration, adjust timing
    [Smart_MoCo.ioc, can_rx.c, can_tx.c, controller.c, controller.h, main.c, main.h]
2026-04-13 Fix encoder bug and add status LED priority
    [can_rx.c, controller.c, controller.h, encoder.c, encoder.h, main.c]
2026-04-18 Switch CAN_UI to use usb serial inerface
2026-04-21 Closed Loop Override and tuned PID
    In progress Closed loop Override
    PID Rough Tuned
2026-04-21 You committed to the wrong repo, bozo
    This reverts commit fa1cbf81540806600e269eb86760297bdc7d91b8.
    [main.py]
2026-04-28 Fix encoder rollover bug
    [controller.c, encoder.c, encoder.h]
2026-05-20 Add LED error codes to README
2026-09-16 Prototype maybe?
2026-10-21 Interrupt Test
2026-10-22 Can on interrupt works
